jorduza/Limpia-Humedales/README.md

### Link a la wiki para la documentacion del trabajo
https://github.com/jorduza/Limpia-Humedales/wiki/0.-HOME
