jorduza/Limpia-Humedales/DIAGRAMAS DE FLUJO DE DISEÑO/DF Interaccion HM.png

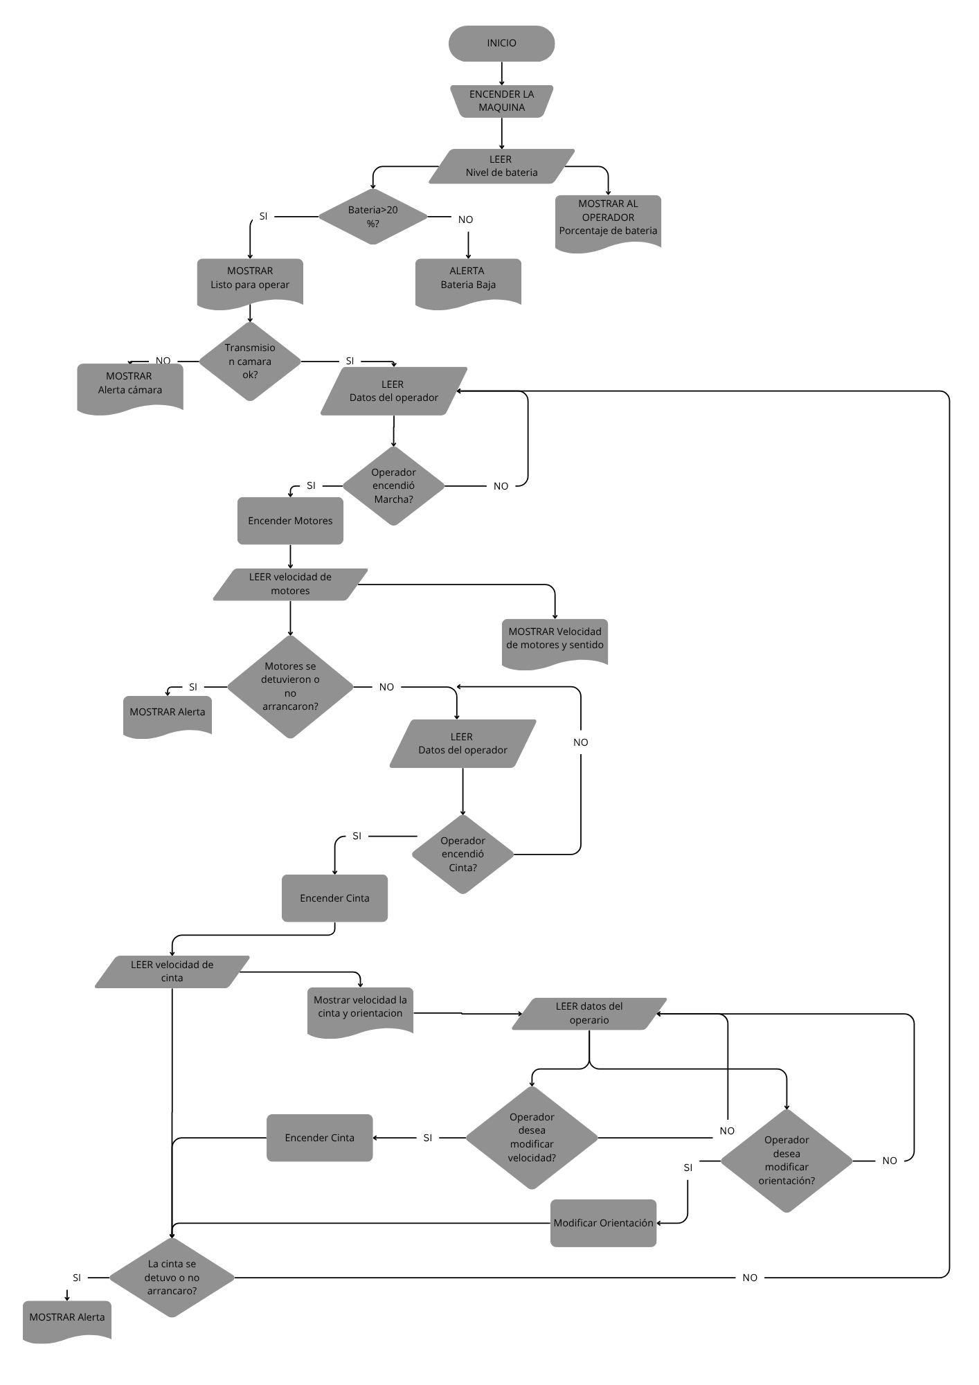
DIAGRAMAS DE FLUJO DE DISEÑO/DF Interaccion HM.png
