jorduza/Limpia-Humedales/DIAGRAMAS DE FLUJO DE DISEÑO/DIAGRAMA CAJA NEGRA.png

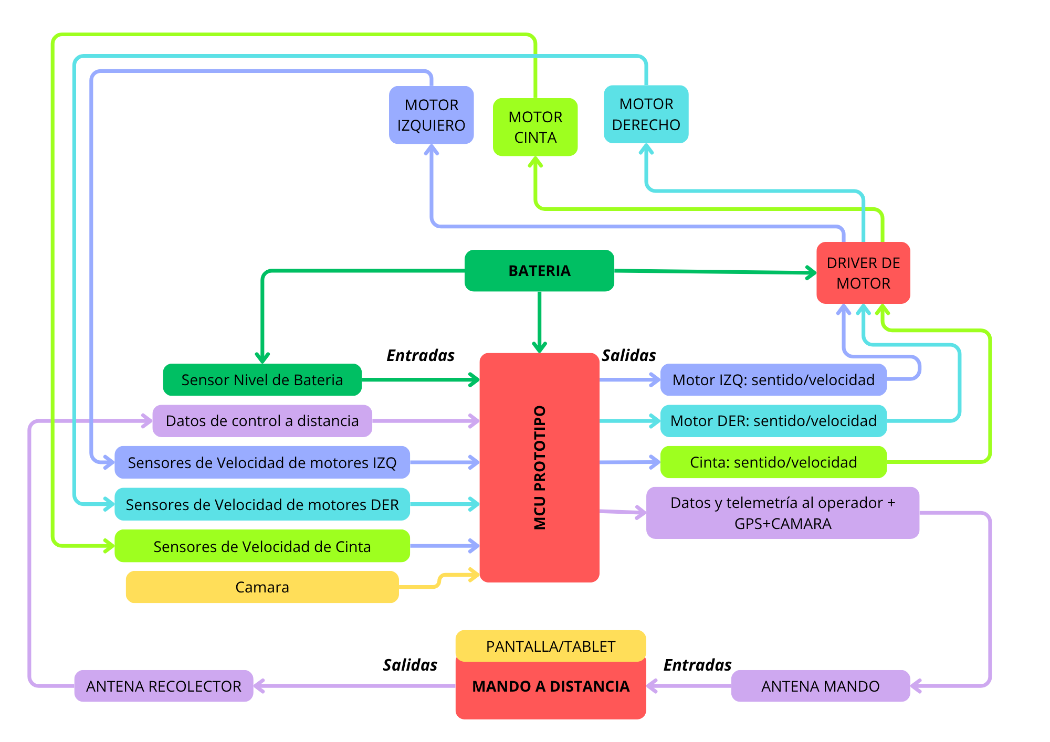
DIAGRAMAS DE FLUJO DE DISEÑO/DIAGRAMA CAJA NEGRA.png
