jorduza/Limpia-Humedales/DIAGRAMAS DE FLUJO DE DISEÑO/DIAGRAMA TECNOLOGICO.png

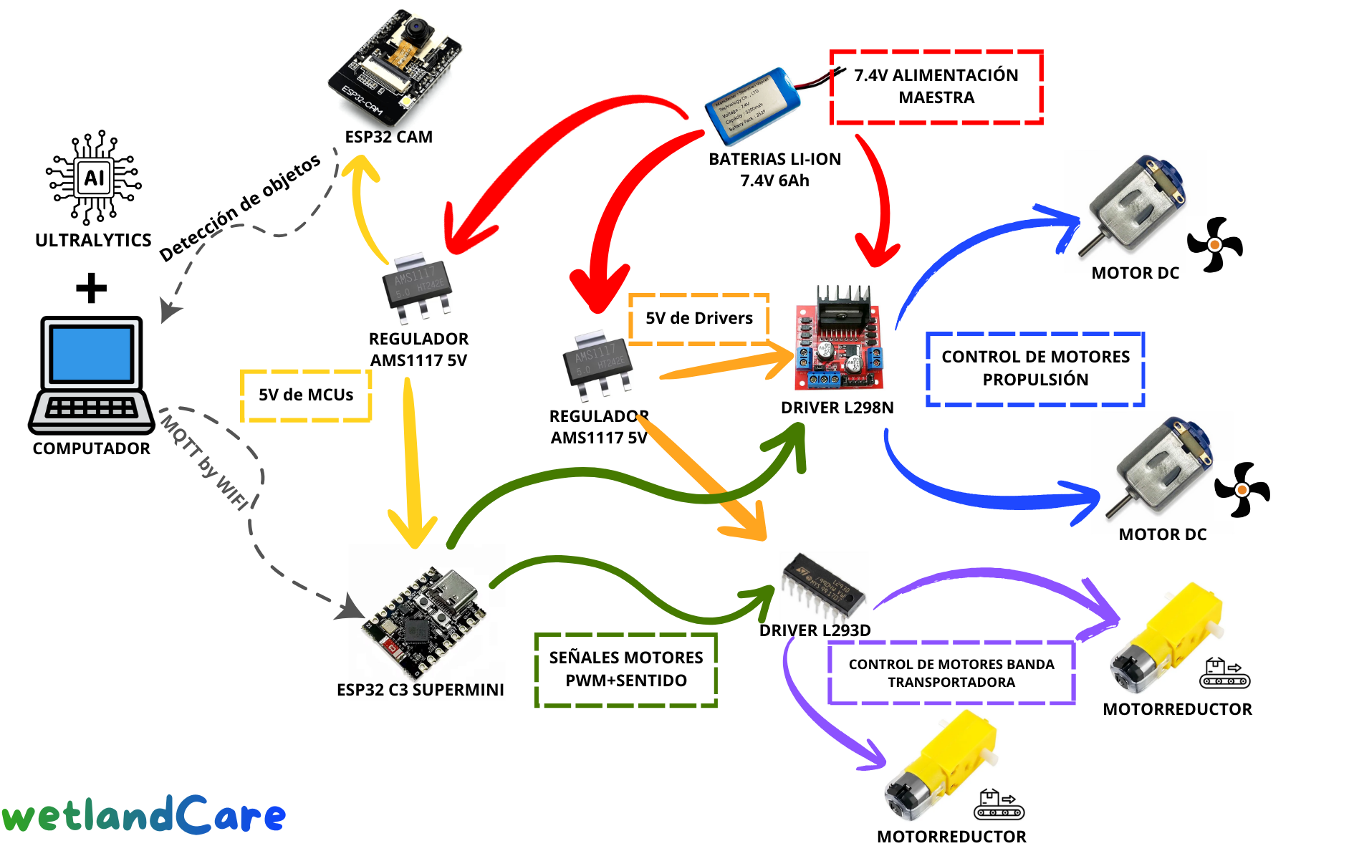
DIAGRAMAS DE FLUJO DE DISEÑO/DIAGRAMA TECNOLOGICO.png
