jorduza/Limpia-Humedales/Case-planos/Planos.prototipo.caja.de.componentes-2.pdf

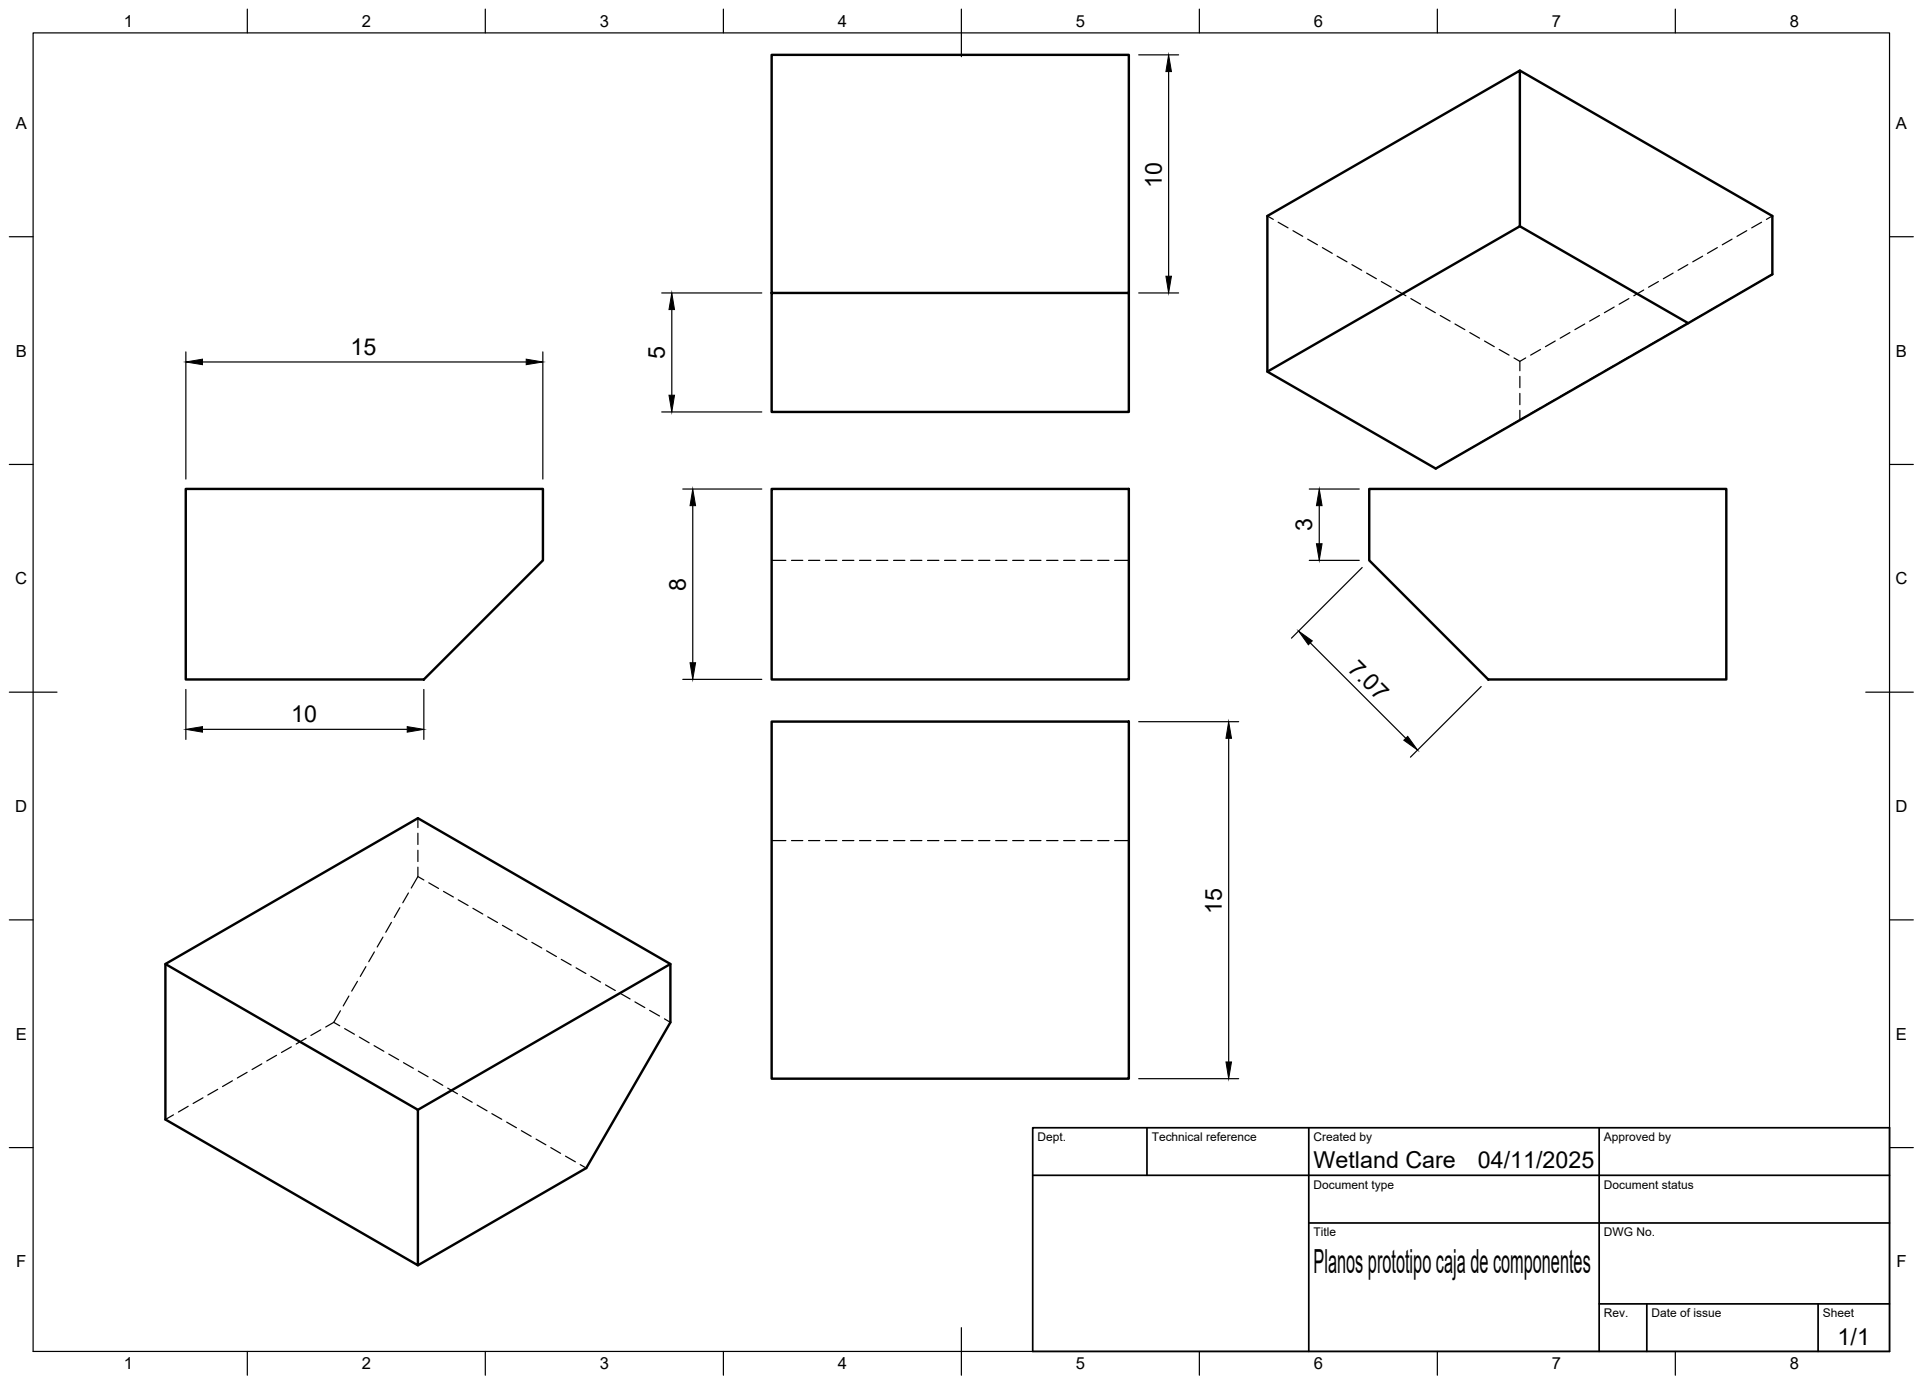
[picture p4: page 1]
Title; DWG No.; Rev.; Date of issue; Sheet

Dept. | Technical reference | Created by Wetland Care 04/11/2025 | Approved by

Document type | Document status

Planos prototipo caja de componentes
