jorduza/Limpia-Humedales/Case-planos/Plano_prototipo_flotadores-1.pdf

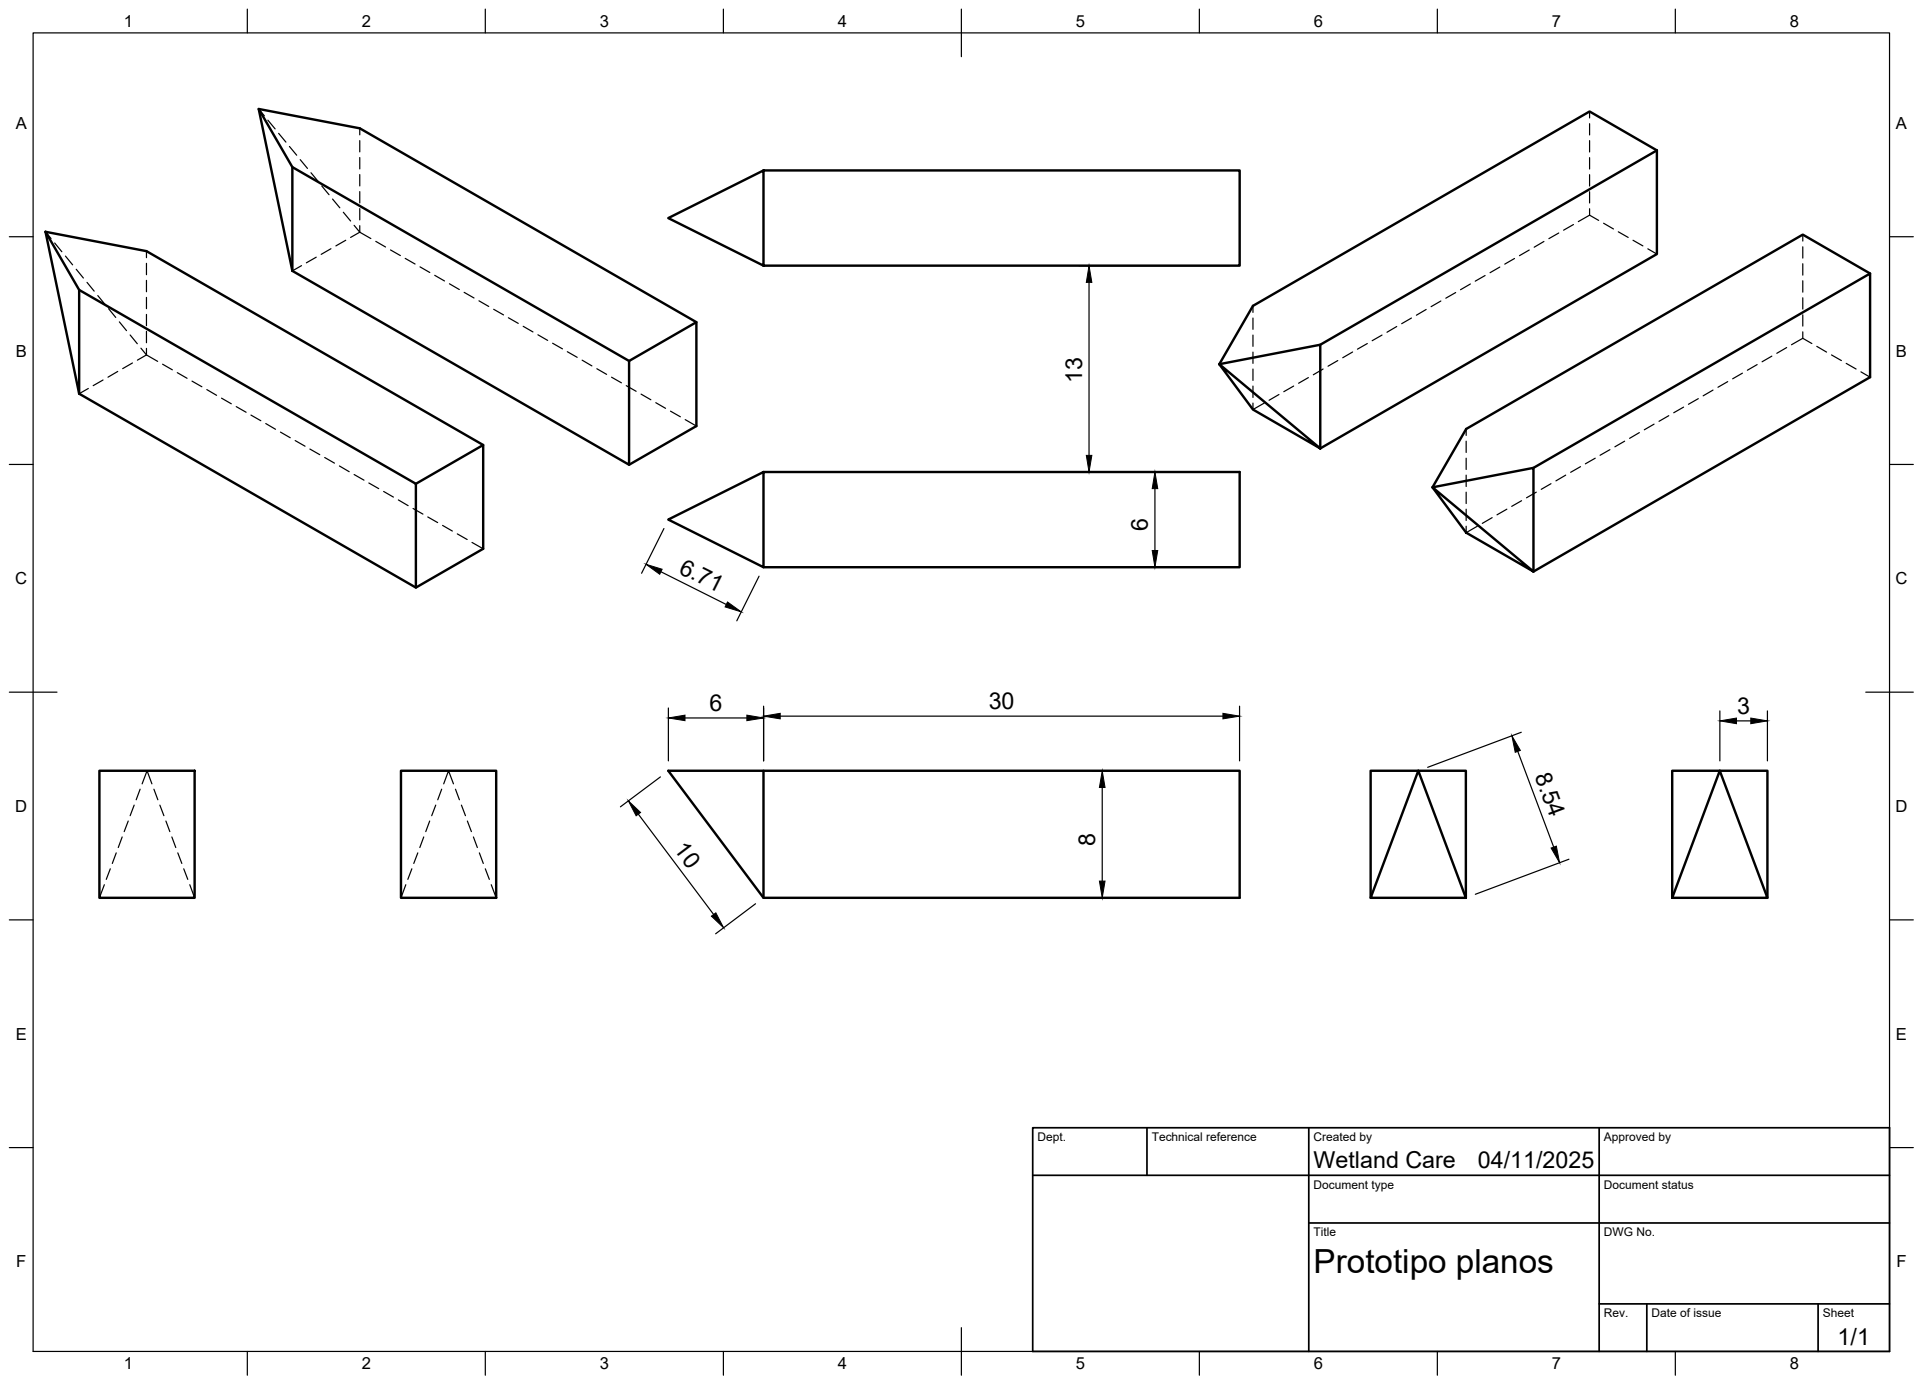
[picture p5: page 1]
Title; DWG No.; Rev.; Date of issue; Sheet; Prototipo planos

Dept. | Technical reference | Created by Wetland Care 04/11/2025 | Approved by

Document type | Document status
