jorduza/Limpia-Humedales/Hardware-PCB/wetLandCare.kicad_pcb

## KiCad design Hardware-PCB/wetLandCare.kicad_pcb (2025-12-09)

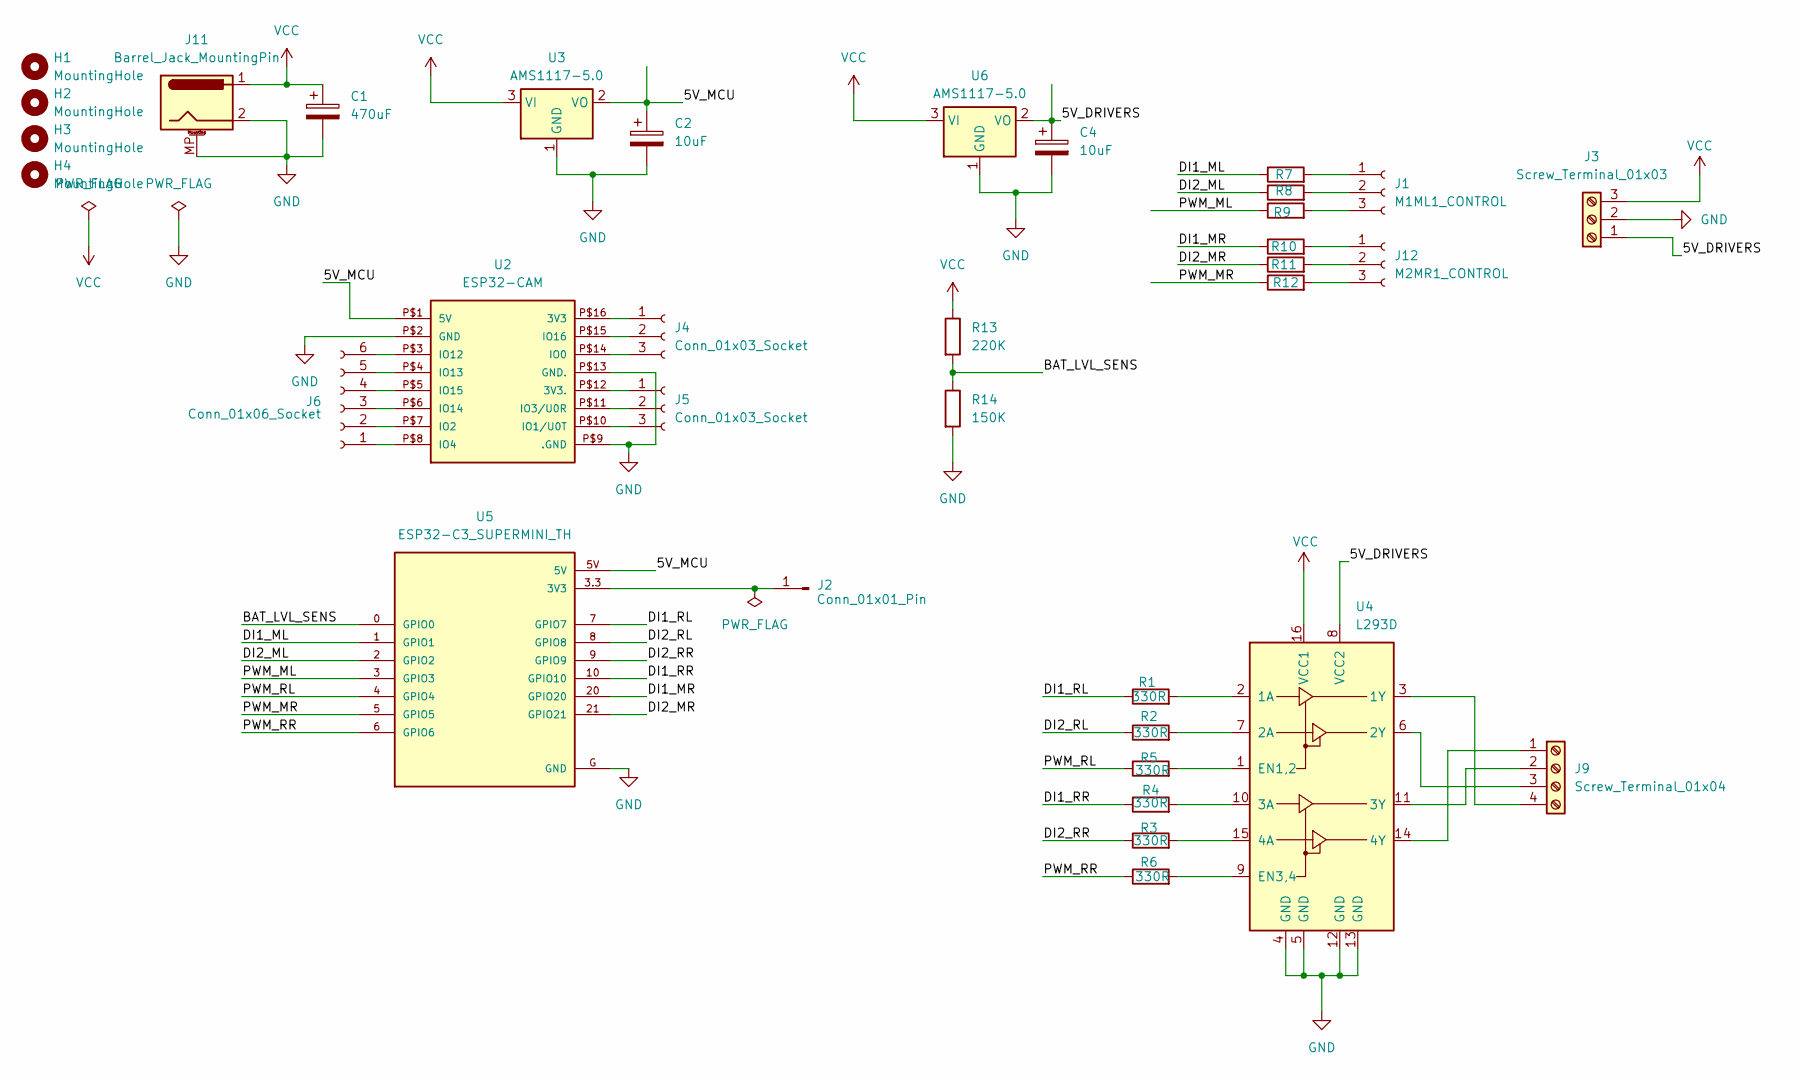
[picture p6: schematic wetLandCare.kicad_sch]

Parts:
C1: 470uF; CP_Radial_D8.0mm_P3.80mm
C2, C4: 10uF; CP_Radial_D4.0mm_P2.00mm
H1, H2, H3, H4: MountingHole; MountingHole_3.2mm_M3_DIN965_Pad
J1: M1ML1_CONTROL; PinSocket_1x03_P2.54mm_Vertical
J2: Conn_01x01_Pin; PinSocket_1x01_P2.54mm_Vertical
J3: Screw_Terminal_01x03; TerminalBlock_Altech_AK300-3_P5.00mm
J4, J5: Conn_01x03_Socket; PinSocket_1x03_P2.54mm_Vertical
J6: Conn_01x06_Socket; PinSocket_1x06_P2.54mm_Vertical
J9: Screw_Terminal_01x04; TerminalBlock_Altech_AK300-4_P5.00mm
J11: Barrel_Jack_MountingPin; BarrelJack_Kycon_KLDX-0202-xC_Horizontal
J12: M2MR1_CONTROL; PinSocket_1x03_P2.54mm_Vertical
R1, R2, R3, R4, R5, R6, R7, R8, R9, R10, R11, R12: 330R; R_Axial_DIN0207_L6.3mm_D2.5mm_P7.62mm_Horizontal
R13: 220K; R_Axial_DIN0207_L6.3mm_D2.5mm_P7.62mm_Horizontal
R14: 150K; R_Axial_DIN0207_L6.3mm_D2.5mm_P7.62mm_Horizontal
U2: ESP32-CAM
U3, U6: AMS1117-5.0; SOT-223-3_TabPin2
U4: L293D; DIP-16_W7.62mm
U5: ESP32-C3_SUPERMINI_TH; MODULE_ESP32-C3_SUPERMINI_TH

Connections:
/5V_DRIVERS: C4.1, J3.1, U4.8 (VCC2), U6.2 (VO)
/5V_MCU: C2.1, U2.P$1 (5V), U3.2 (VO), U5.5V
/BAT_LVL_SENS: R13.2, R14.1, U5.0 (GPIO0)
/DI1_ML: R7.1, U5.1 (GPIO1)
/DI1_MR: R10.1, U5.20 (GPIO20)
/DI1_RL: R1.1, U5.7 (GPIO7)
/DI1_RR: R4.1, U5.10 (GPIO10)
/DI2_ML: R8.1, U5.2 (GPIO2)
/DI2_MR: R11.1, U5.21 (GPIO21)
/DI2_RL: R2.1, U5.8 (GPIO8)
/DI2_RR: R3.1, U5.9 (GPIO9)
/PWM_ML: R9.1, U5.3 (GPIO3)
/PWM_MR: R12.1, U5.5 (GPIO5)
/PWM_RL: R5.1, U5.4 (GPIO4)
/PWM_RR: R6.1, U5.6 (GPIO6)
GND: C1.2, C2.2, C4.2, J3.2, J11.2, J11.MP, R14.2, U2.P$2 (GND), U2.P$9 (.GND), U2.P$13 (GND.), U3.1 (GND), U4.4 (GND), U4.5 (GND), U4.12 (GND), U4.13 (GND), U5.G (GND), U6.1 (GND)
unnamed: J1.1, R7.2
unnamed: J1.2, R8.2
unnamed: J1.3, R9.2
unnamed: J2.1, U5.3.3 (3V3)
unnamed: J4.1, U2.P$16 (3V3)
unnamed: J4.2, U2.P$15 (IO16)
unnamed: J4.3, U2.P$14 (IO0)
unnamed: J5.1, U2.P$12 (3V3.)
unnamed: J5.2, U2.P$11 (IO3/U0R)
unnamed: J5.3, U2.P$10 (IO1/U0T)
unnamed: J6.1, U2.P$8 (IO4)
unnamed: J6.2, U2.P$7 (IO2)
unnamed: J6.3, U2.P$6 (IO14)
unnamed: J6.4, U2.P$5 (IO15)
unnamed: J6.5, U2.P$4 (IO13)
unnamed: J6.6, U2.P$3 (IO12)
unnamed: J9.1, U4.14 (4Y)
unnamed: J9.2, U4.11 (3Y)
unnamed: J9.3, U4.6 (2Y)
unnamed: J9.4, U4.3 (1Y)
unnamed: J12.1, R10.2
unnamed: J12.2, R11.2
unnamed: J12.3, R12.2
unnamed: R1.2, U4.2 (1A)
unnamed: R2.2, U4.7 (2A)
unnamed: R4.2, U4.10 (3A)
unnamed: R3.2, U4.15 (4A)
unnamed: R5.2, U4.1 (EN1,2)
unnamed: R6.2, U4.9 (EN3,4)
VCC: C1.1, J3.3, J11.1, R13.1, U3.3 (VI), U4.16 (VCC1), U6.3 (VI)

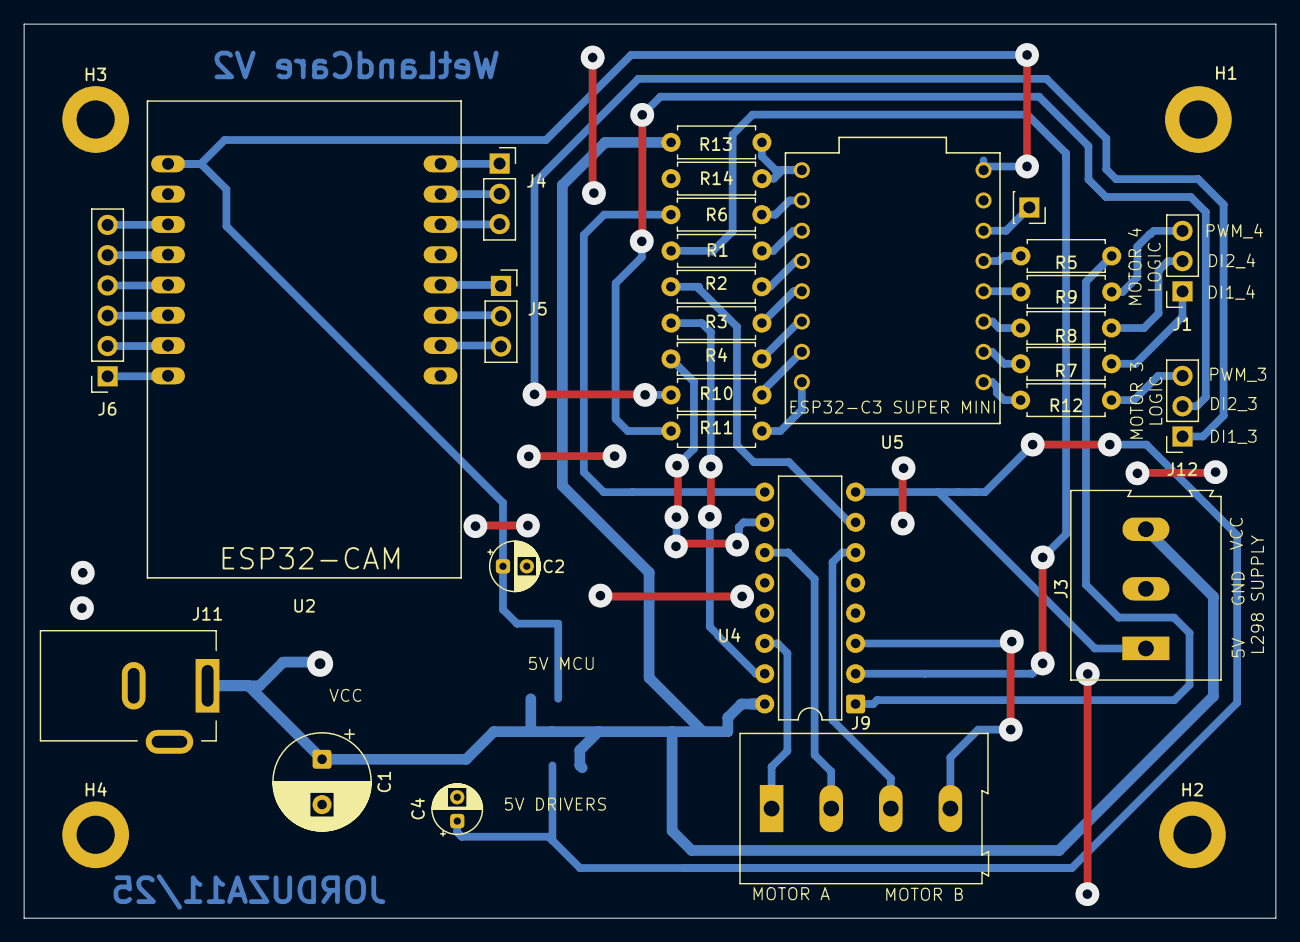
[picture p7: board wetLandCare.kicad_pcb from above]

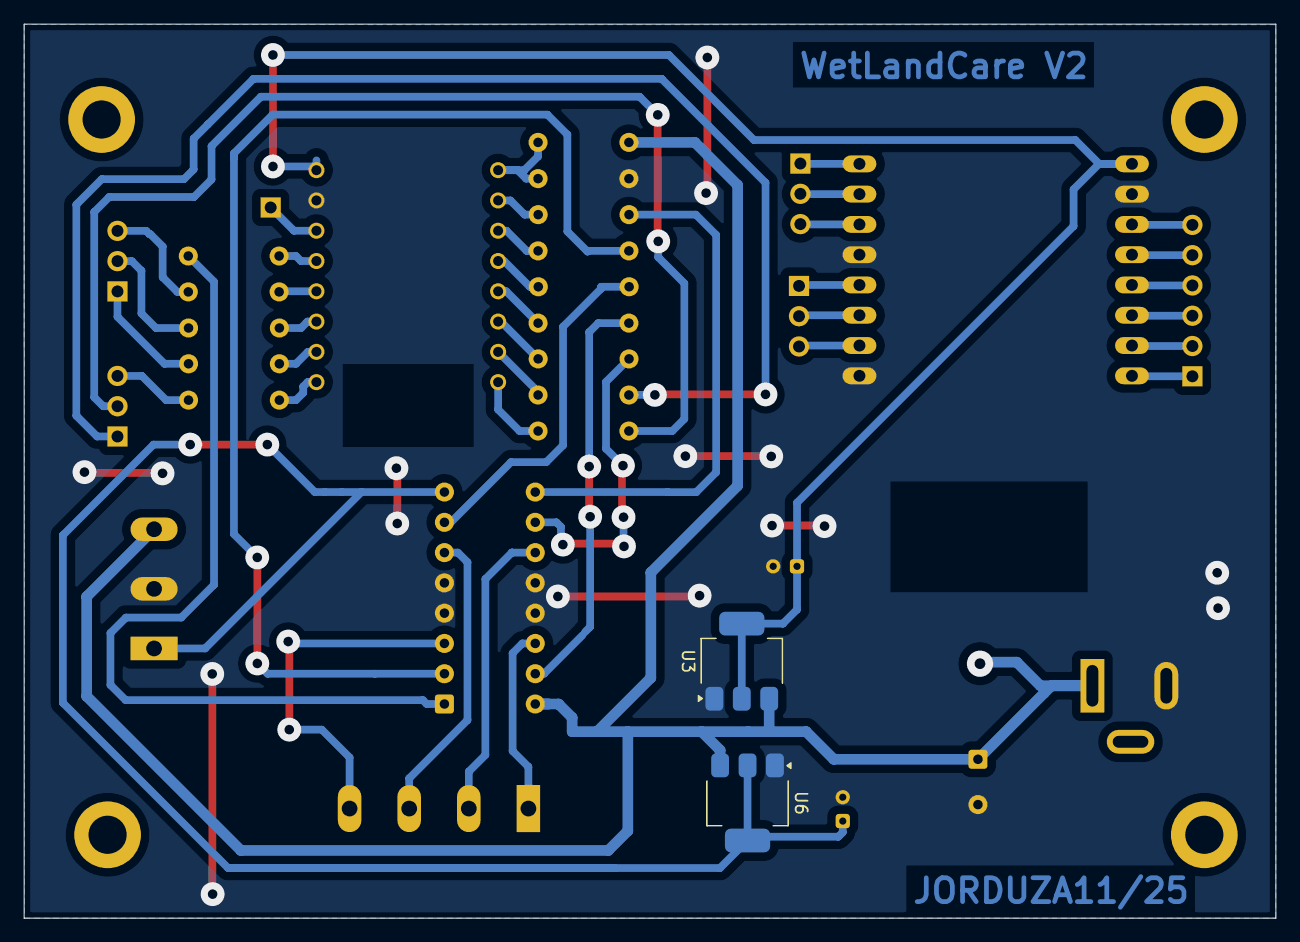
[picture p8: board wetLandCare.kicad_pcb from below]

Board: 2 copper layers, 105.0 x 75.0 mm, 35 parts (2 on the bottom side), 46 nets.
