jorduza/Limpia-Humedales/(commit log)

2025-11-12 Add files via upload
    Dathasheets de los componentes usados en el proyecto
2025-11-12 Add files via upload
    Modificación y complementación del diagrama esquemático como parte del diseño técnico del prototipo
    [wetLandCare.kicad_sch]
2025-11-15 added via upload
    Modificaciones al esquemático y diseño del circuito impreso
    [wetLandCare.kicad_pcb, wetLandCare.kicad_sch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]
2025-12-09 updated kicad files
    [wetLandCare.kicad_pcb, wetLandCare.kicad_sch]
